Abit-byte/Triple-S-Generator/Triple-S Generator.kicad_pcb

## KiCad design Triple-S Generator.kicad_pcb (2026-06-30)

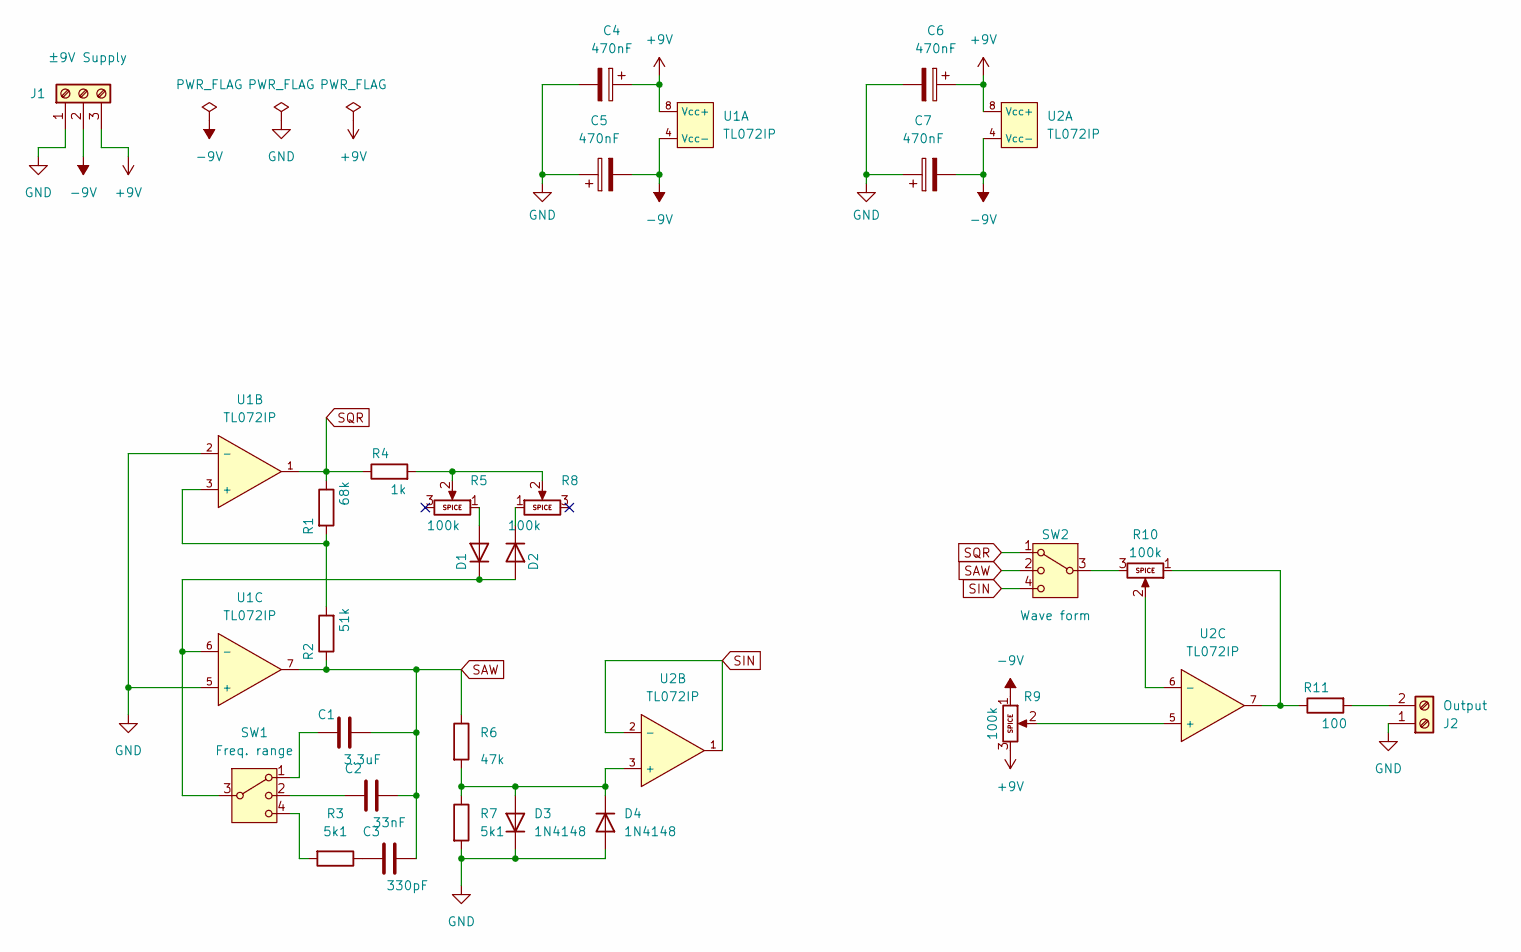
[picture p3: schematic Triple-S Generator.kicad_sch]

Parts:
C1: 3.3uF; C_Rect_L16.5mm_W7.0mm_P15.00mm_MKT
C2: 33nF; C_Disc_D4.3mm_W1.9mm_P5.00mm
C3: 330pF; C_Disc_D4.3mm_W1.9mm_P5.00mm
C4, C5, C6, C7: 470nF; CP_Radial_D6.3mm_P2.50mm
D1, D2, D3, D4: 1N4148; D_DO-35_SOD27_P7.62mm_Horizontal
J1: ±9V Supply; Terminal Block 3 pos
J2: Output; Terminal Block 2 pos
R1: 68k; R_Axial_DIN0207_L6.3mm_D2.5mm_P7.62mm_Horizontal
R2: 51k; R_Axial_DIN0207_L6.3mm_D2.5mm_P7.62mm_Horizontal
R3, R7: 5k1; R_Axial_DIN0207_L6.3mm_D2.5mm_P7.62mm_Horizontal
R4: 1k; R_Axial_DIN0207_L6.3mm_D2.5mm_P7.62mm_Horizontal
R5, R8, R9, R10: 100k; Potentiometer_Alpha_RD901F-40-00D_Single_Vertical
R6: 47k; R_Axial_DIN0207_L6.3mm_D2.5mm_P7.62mm_Horizontal
R11: 100; R_Axial_DIN0207_L6.3mm_D2.5mm_P7.62mm_Horizontal
SW1: Freq. range; Switch SP3T
SW2: Wave form; Switch SP3T
U1, U2: TL072IP; 8-Dip

Connections:
+9V: C4.1, C6.1, J1.3, R9.3, U1.8 (Vcc+), U2.8 (Vcc+)
-9V: C5.2, C7.2, J1.2, R9.1, U1.4 (Vcc-), U2.4 (Vcc-)
GND: C4.2, C5.1, C6.2, C7.1, D3.1 (K), D4.2 (A), J1.1, J2.1, R7.2, U1.2 (-), U1.5 (+)
unnamed: C1.1, SW1.1
unnamed: C2.1, SW1.2
unnamed: C3.1, R3.1
unnamed: D1.2 (A), R5.1
unnamed: D1.1 (K), D2.2 (A), SW1.3, U1.6 (-)
unnamed: D2.1 (K), R8.1
unnamed: D3.2 (A), D4.1 (K), R6.2, R7.1, U2.3 (+)
unnamed: J2.2, R11.2
unnamed: R3.2, SW1.4
unnamed: R4.2, R5.2, R8.2
unnamed: R10.1, R11.1, U2.7
unnamed: R10.3, SW2.3
unnamed: R1.2, R2.2, U1.3 (+)
unnamed: R9.2, U2.5 (+)
unnamed: R10.2, U2.6 (-)
SAW: C1.2, C2.2, C3.2, R2.1, R6.1, SW2.2, U1.7
SIN: SW2.4, U2.1, U2.2 (-)
SQR: R1.1, R4.1, SW2.1, U1.1

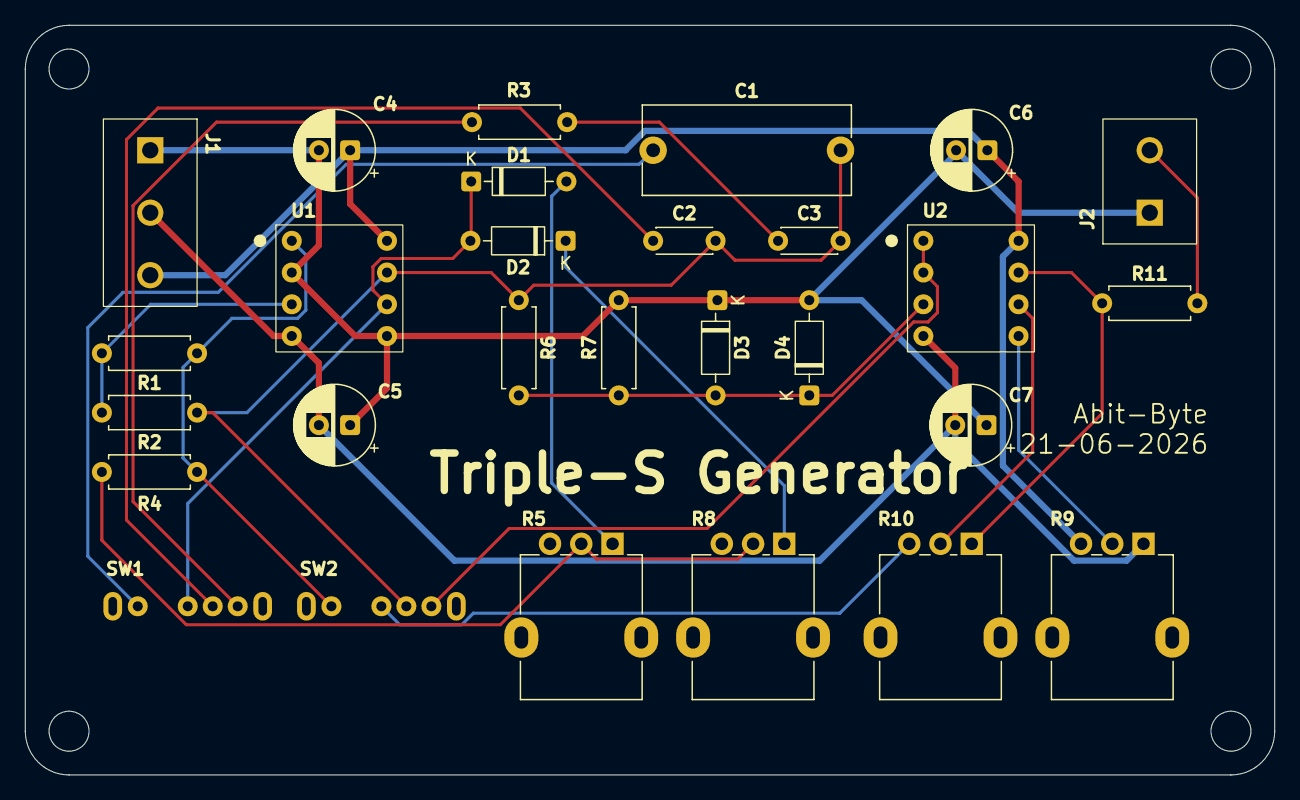
[picture p4: board Triple-S Generator.kicad_pcb from above]

Board: 2 copper layers, 100.0 x 60.0 mm, 28 parts (0 on the bottom side), 21 nets.
