Abit-byte/Triple-S-Generator/Photos-of-final-result/PCB_back.jpg

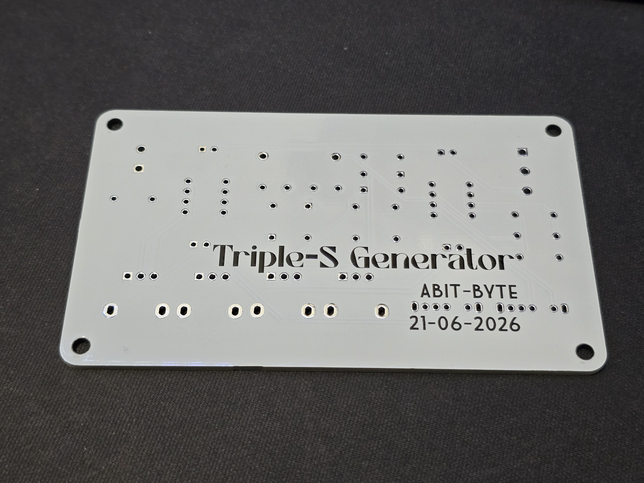
Photos-of-final-result/PCB_back.jpg
