Abit-byte/Triple-S-Generator/Photos-of-final-result/PCB_front.jpg

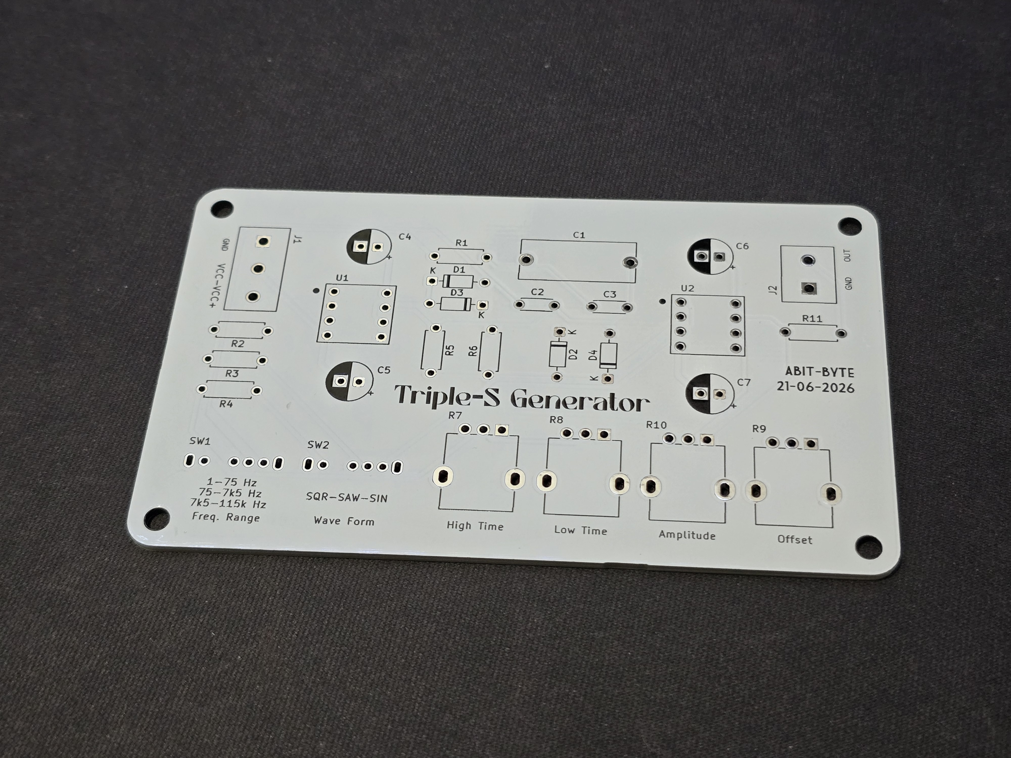
Photos-of-final-result/PCB_front.jpg
